innovationcentralph/LakeQualityMonitoring/KiCad Files/DOST_MainUnit/DOST_MainUnit.kicad_pcb

## KiCad design KiCad Files/DOST_MainUnit/DOST_MainUnit.kicad_pcb (2025-04-25)

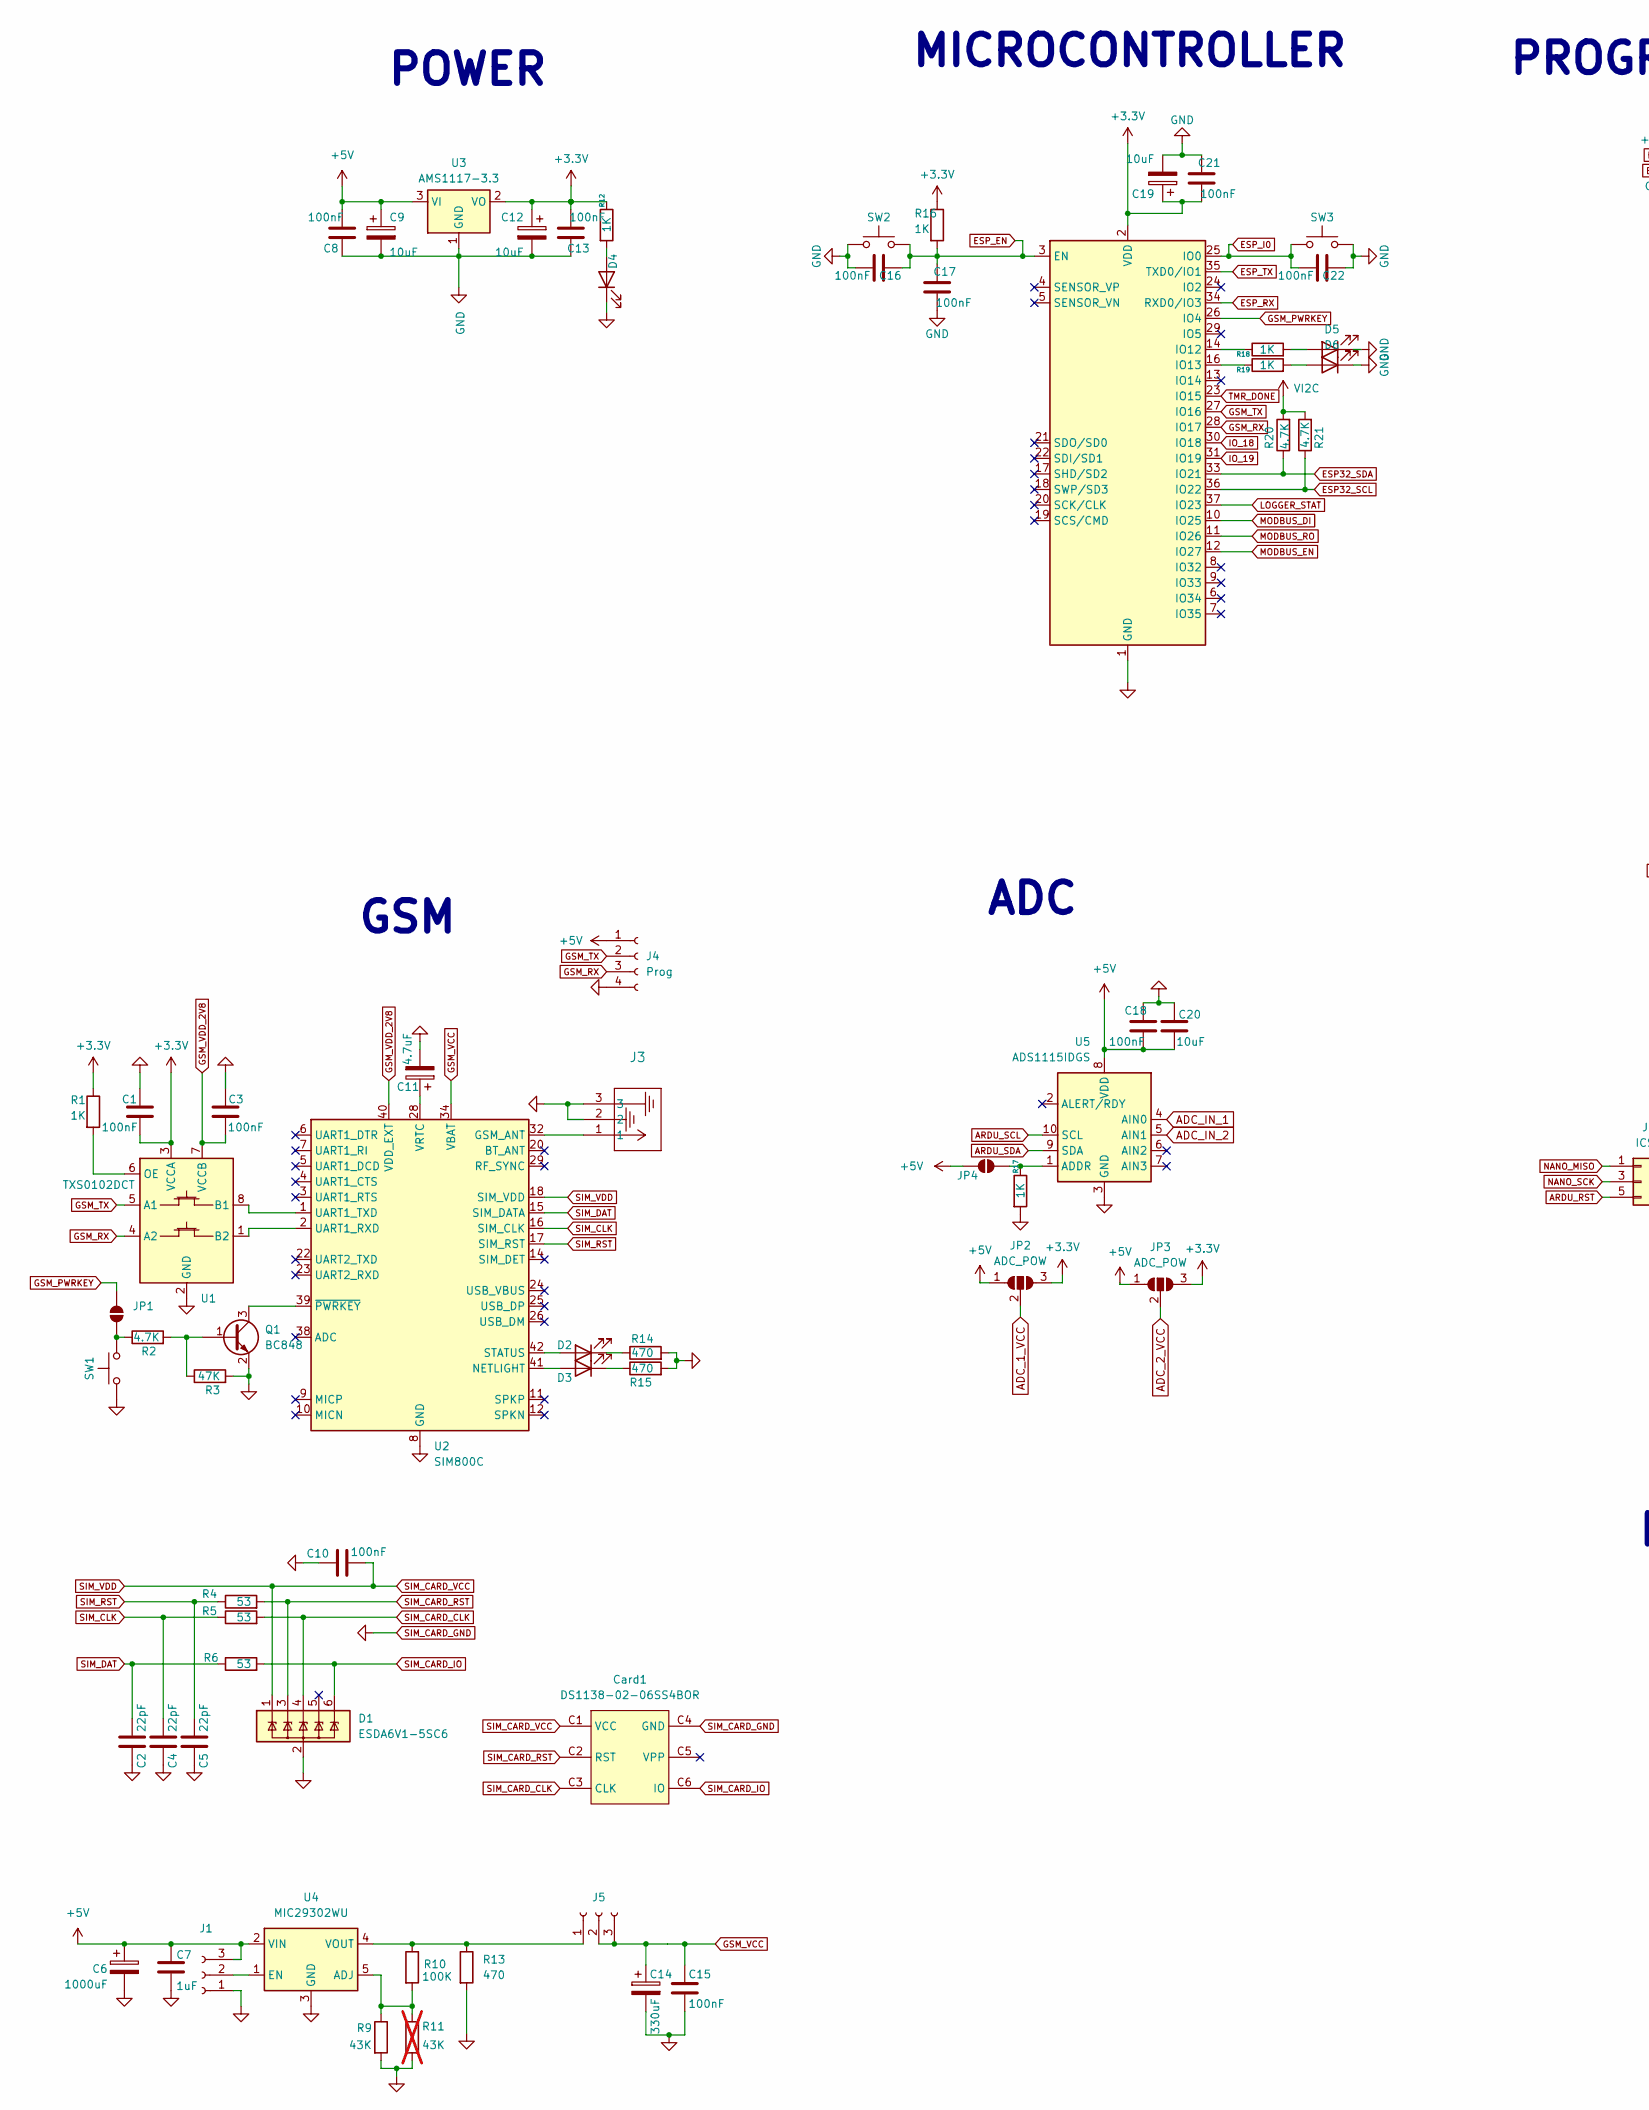
[picture p1: schematic DOST_MainUnit.kicad_sch, part in row 1, column 1]

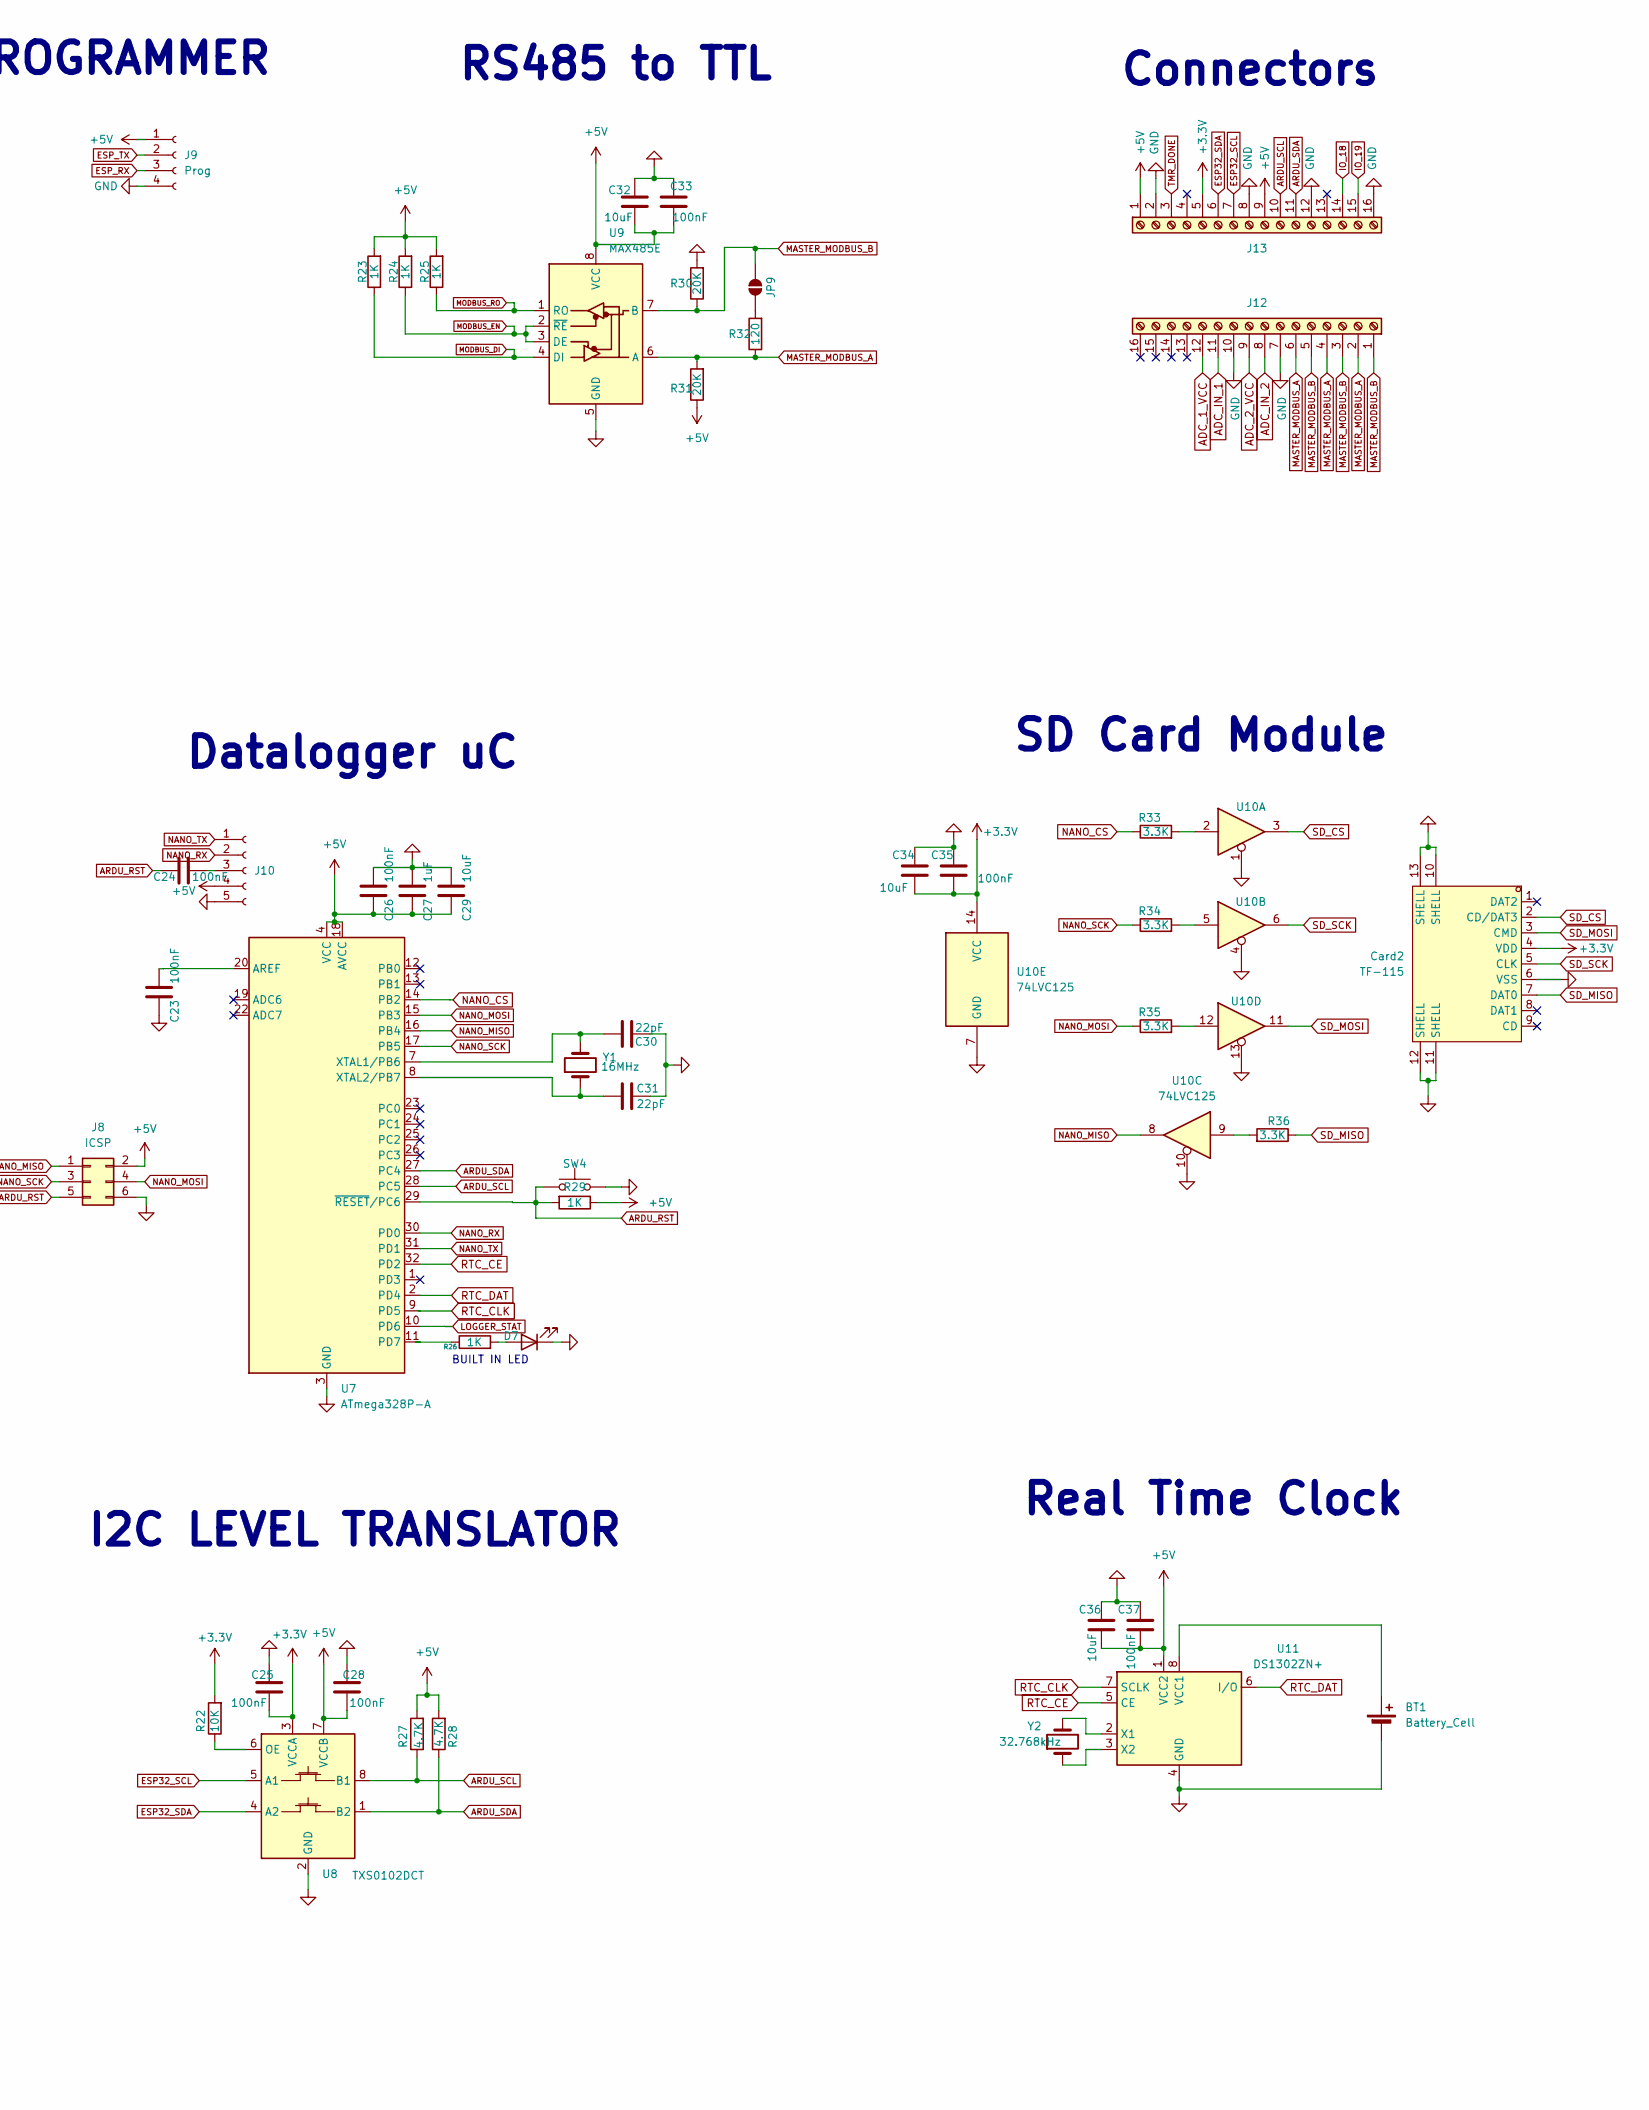
[picture p2: schematic DOST_MainUnit.kicad_sch, part in row 1, column 2]

Parts:
BT1: Battery_Cell; BAT-TH_CR2032-BS-6-1; LCSC C70377
C1, C3, C25, C28: 100nF; C_0805_2012Metric_Pad1.18x1.45mm_HandSolder; LCSC C1546
C2, C4, C5: 22pF; C_0805_2012Metric_Pad1.18x1.45mm_HandSolder
C6: 1000uF; CP_Elec_10x10.5
C7: 1uF; C_0805_2012Metric_Pad1.18x1.45mm_HandSolder
C8, C13, C16, C17, C18, C21, C22, C23, C24, C26, C33, C35, C37: 100nF; C_0805_2012Metric_Pad1.18x1.45mm_HandSolder; LCSC C60474
C9, C12, C19, C32: 10uF; C_0805_2012Metric_Pad1.18x1.45mm_HandSolder; LCSC C15850
C10, C15: 100nF; C_0805_2012Metric_Pad1.18x1.45mm_HandSolder
C11: 4.7uF; CP_EIA-3528-12_Kemet-T_Pad1.50x2.35mm_HandSolder
C14: 330uF; CP_EIA-7343-31_Kemet-D_Pad2.25x2.55mm_HandSolder
C20, C29, C34, C36: 10uF; C_0805_2012Metric_Pad1.18x1.45mm_HandSolder; LCSC C96446
C27: 1uF; C_0805_2012Metric_Pad1.18x1.45mm_HandSolder; LCSC C52923
C30, C31: 22pF; C_0805_2012Metric_Pad1.18x1.45mm_HandSolder; LCSC C96446
Card1: DS1138-02-06SS4BOR; SIM-SMD_DS1138-02-06SS4BOR; LCSC Part C91413
Card2: TF-115; TF-SMD_TF-115; LCSC C266620
D1: ESDA6V1-5SC6; SOT-23-6
D2, D3: LED; LED_0805_2012Metric_Pad1.15x1.40mm_HandSolder
D4, D5, D6, D7: LED; LED_0805_2012Metric_Pad1.15x1.40mm_HandSolder; LCSC C2297
J1, J5: Conn_01x03_Socket; PinHeader_1x03_P2.54mm_Vertical
J3: CONUFL001-SMD-T; CONN1_CONUFL_TEC
J4, J9: Prog; PinHeader_1x04_P2.54mm_Vertical
J8: ICSP; PinHeader_2x03_P2.54mm_Vertical_SMD
J10: Conn_01x05_Socket; PinHeader_1x05_P2.54mm_Vertical
J12, J13: Screw_Terminal_01x16; TerminalBlock_Phoenix_MKDS-1,5-16-5.08_1x16_P5.08mm_Horizon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
JP1, JP4, JP9: SolderJumper_2_Open; SolderJumper-2_P1.3mm_Open_Pad1.0x1.5mm
JP2, JP3: ADC_POW; SolderJumper-3_P1.3mm_Open_Pad1.0x1.5mm
Q1: BC848; SOT-23
R1, R12, R16, R17, R18, R19, R23, R24, R25, R26, R29: 1K; R_0603_1608Metric_Pad0.98x0.95mm_HandSolder; LCSC C21190
R2: 4.7K; R_0603_1608Metric_Pad0.98x0.95mm_HandSolder
R3: 47K; R_0805_2012Metric_Pad1.20x1.40mm_HandSolder
R4, R5, R6: 53; R_0805_2012Metric_Pad1.20x1.40mm_HandSolder
R9: 43K; R_0805_2012Metric_Pad1.20x1.40mm_HandSolder
R10: 100K; R_0805_2012Metric_Pad1.20x1.40mm_HandSolder
R11: 43K; R_0805_2012Metric_Pad1.20x1.40mm_HandSolder; not fitted
R13, R14, R15: 470; R_0805_2012Metric_Pad1.20x1.40mm_HandSolder
R20, R21, R27, R28: 4.7K; R_0603_1608Metric_Pad0.98x0.95mm_HandSolder; LCSC C23162
R22: 10K; R_0603_1608Metric_Pad0.98x0.95mm_HandSolder; LCSC C25804
R30, R31: 20K; R_0805_2012Metric_Pad1.20x1.40mm_HandSolder; LCSC C163978
R32: 120; R_0805_2012Metric_Pad1.20x1.40mm_HandSolder; LCSC C2907224
R33, R34, R35, R36: 3.3K; R_0603_1608Metric_Pad0.98x0.95mm_HandSolder; LCSC C22978
SW1, SW2, SW3, SW4: SW_Push; SW_SPST_CK_RS282G05A3; LCSC C2689642
U1, U8: TXS0102DCT; SSOP-8_2.95x2.8mm_P0.65mm
U2: SIM800C; SIMCom_SIM800C
U3: AMS1117-3.3; SOT-223-3_TabPin2
U4: MIC29302WU; TO-263-5_TabPin3
U5: ADS1115IDGS; VSSOP-10_3x3mm_P0.5mm; LCSC C37593
U6: ESP32-WROOM-32; LCSC C529577
U7: ATmega328P-A; TQFP-32_7x7mm_P0.8mm; LCSC C14877
U9: MAX485E; SOP-8_3.9x4.9mm_P1.27mm; LCSC C481667
U10: 74LVC125; TSSOP-14_L5.0-W4.4-P0.65-LS6.4-BL; LCSC C6059
U11: DS1302ZN+; SOIC-8_3.9x4.9mm_P1.27mm; LCSC C14334
Y1: 16MHz; Crystal_HC49-4H_Vertical
Y2: 32.768kHz; Crystal_C38-LF_D3.0mm_L8.0mm_Vertical; LCSC C97606

Connections:
+3.3V: C1.2, C12.1, C13.1, C19.1, C21.1, C25.2, C34.1, C35.1, Card2.4 (VDD), J13.5, JP2.3 (B), JP3.3 (B), R1.1, R12.1, R16.1, R22.2, U1.3 (VCCA), U3.2 (VO), U6.2 (VDD), U8.3 (VCCA), U10.14 (VCC)
+5V: C6.1, C7.1, C8.1, C9.1, C18.1, C20.2, C26.2, C27.2, C28.2, C29.2, C32.2, C33.1, C36.1, C37.1, J1.3, J4.1, J8.2, J9.1, J10.4, J13.1, J13.9, JP2.1 (A), JP3.1 (A), JP4.2 (B), R23.2, R24.2, R25.2, R27.2, R28.2, R29.1, R31.1, U3.3 (VI), U4.2 (VIN), U5.8 (VDD), U7.4 (VCC), U7.6 (VCC), U7.18 (AVCC), U8.7 (VCCB), U9.8 (VCC), U11.1 (VCC2)
ADC_1_VCC: J12.12, JP2.2 (C)
ADC_2_VCC: J12.9, JP3.2 (C)
ADC_IN_1: J12.11, U5.4 (AIN0)
ADC_IN_2: J12.8, U5.5 (AIN1)
ARDU_RST: C24.2, J8.5, R29.2, SW4.1, U7.29 (~RESET/PC6)
ARDU_SCL: J13.10, R27.1, U5.10 (SCL), U7.28 (PC5), U8.8 (B1)
ARDU_SDA: J13.11, R28.1, U5.9 (SDA), U7.27 (PC4), U8.1 (B2)
ESP32_SCL: J13.7, R21.1, U6.36 (IO22), U8.5 (A1)
ESP32_SDA: J13.6, R20.1, U6.33 (IO21), U8.4 (A2)
ESP_EN: C16.2, C17.2, R16.2, SW2.2, U6.3 (EN)
ESP_I0: C22.1, SW3.1, U6.25 (IO0)
ESP_RX: J9.3, U6.34 (RXD0/IO3)
ESP_TX: J9.2, U6.35 (TXD0/IO1)
GSM_PWRKEY: JP1.2 (B), U6.26 (IO4)
GSM_RX: J4.3, U1.4 (A2), U6.28 (IO17)
GSM_TX: J4.2, U1.5 (A1), U6.27 (IO16)
GSM_VCC: C14.1, C15.1, J5.2, J5.3, U2.34 (VBAT), U2.35 (VBAT)
GSM_VDD_2V8: C3.2, U1.7 (VCCB), U2.40 (VDD_EXT)
IO_18: J13.14, U6.30 (IO18)
IO_19: J13.15, U6.31 (IO19)
LOGGER_STAT: U6.37 (IO23), U7.10 (PD6)
MASTER_MODBUS_A: J12.2, J12.4, J12.6, R31.2, R32.1, U9.6 (A)
MASTER_MODBUS_B: J12.1, J12.3, J12.5, JP9.2 (B), R30.1, U9.7 (B)
MODBUS_DI: R23.1, U6.10 (IO25), U9.4 (DI)
MODBUS_EN: R24.1, U6.12 (IO27), U9.2 (~RE), U9.3 (DE)
MODBUS_RO: R25.1, U6.11 (IO26), U9.1 (RO)
NANO_CS: R33.1, U7.14 (PB2)
NANO_MISO: J8.1, U7.16 (PB4), U10.8
NANO_MOSI: J8.4, R35.1, U7.15 (PB3)
NANO_RX: J10.2, U7.30 (PD0)
NANO_SCK: J8.3, R34.1, U7.17 (PB5)
NANO_TX: J10.1, U7.31 (PD1)
unnamed: BT1.1 (+), U11.8 (VCC1)
unnamed: D2.2 (A), U2.42 (STATUS)
unnamed: D2.1 (K), R14.1
unnamed: D3.2 (A), U2.41 (NETLIGHT)
unnamed: D3.1 (K), R15.1
unnamed: D4.2 (A), R12.2
unnamed: D5.2 (A), R18.2
unnamed: D6.2 (A), R19.2
unnamed: D7.2 (A), R26.2
unnamed: J1.2, U4.1 (EN)
unnamed: J5.1, R10.1, R13.1, U4.4 (VOUT)
unnamed: C24.1, J10.3
unnamed: JP1.1 (A), R2.1, SW1.2
unnamed: JP4.1 (A), R17.1, U5.1 (ADDR)
unnamed: JP9.1 (A), R32.2
unnamed: Q1.1 (B), R2.2, R3.1
unnamed: Q1.3 (C), U2.39 (~PWRKEY)
unnamed: R33.2, U10.2
unnamed: R34.2, U10.5
unnamed: R35.2, U10.12
unnamed: R36.2, U10.9
unnamed: U1.8 (B1), U2.1 (UART1_TXD)
unnamed: U1.1 (B2), U2.2 (UART1_RXD)
unnamed: R1.2, U1.6 (OE)
unnamed: J3.1, U2.32 (GSM_ANT)
unnamed: C11.1, U2.28 (VRTC)
unnamed: R9.1, R10.2, R11.1, U4.5 (ADJ)
unnamed: R18.1, U6.14 (IO12)
unnamed: R19.1, U6.16 (IO13)
unnamed: C23.1, U7.20 (AREF)
unnamed: R26.1, U7.11 (PD7)
unnamed: C30.1, U7.7 (XTAL1/PB6), Y1.2
unnamed: C31.1, U7.8 (XTAL2/PB7), Y1.1
unnamed: R22.1, U8.6 (OE)
unnamed: U11.2 (X1), Y2.2
unnamed: U11.3 (X2), Y2.1
RTC_CE: U7.32 (PD2), U11.5 (CE)
RTC_CLK: U7.9 (PD5), U11.7 (SCLK)
RTC_DAT: U7.2 (PD4), U11.6 (I/O)
SD_CS: Card2.2 (CD/DAT3), U10.3
SD_MISO: Card2.7 (DAT0), R36.1
SD_MOSI: Card2.3 (CMD), U10.11
SD_SCK: Card2.5 (CLK), U10.6
SIM_CARD_CLK: Card1.C3 (CLK), D1.4 (IO3), R5.2
SIM_CARD_GND: BT1.2 (-), C1.1, C2.1, C3.1, C4.1, C5.1, C6.2, C7.2, C8.2, C9.2, C10.1, C11.2, C12.2, C13.2, C14.2, C15.2, C16.1, C17.1, C18.2, C19.2, C20.1, C21.2, C22.2, C23.2, C25.1, C26.1, C27.1, C28.1, C29.1, C30.2, C31.2, C32.1, C33.2, C34.2, C35.2, C36.2, C37.2, Card1.C4 (GND), Card2.6 (VSS), Card2.10 (SHELL), Card2.11 (SHELL), Card2.12 (SHELL), Card2.13 (SHELL), D1.2 (GND), D4.1 (K), D5.1 (K), D6.1 (K), D7.1 (K), J1.1, J3.2, J3.3, J4.4, J8.6, J9.4, J10.5, J12.7, J12.10, J13.2, J13.8, J13.12, J13.16, Q1.2 (E), R3.2, R9.2, R11.2, R13.2, R14.2, R15.2, R17.2, R30.2, SW1.1, SW2.1, SW3.2, SW4.2, U1.2 (GND), U2.8 (GND), U2.13 (GND), U2.19 (GND), U2.21 (GND), U2.27 (GND), U2.30 (GND), U2.31 (GND), U2.33 (GND), U2.36 (GND), U2.37 (GND), U3.1 (GND), U4.3 (GND), U5.3 (GND), U6.1 (GND), U6.15 (GND), U6.38 (GND), U6.39 (GND), U7.3 (GND), U7.5 (GND), U7.21 (GND), U8.2 (GND), U9.5 (GND), U10.1, U10.4, U10.7 (GND), U10.10, U10.13, U11.4 (GND)
SIM_CARD_IO: Card1.C6 (IO), D1.6 (IO5), R6.2
SIM_CARD_RST: Card1.C2 (RST), D1.3 (IO2), R4.2
SIM_CARD_VCC: C10.2, Card1.C1 (VCC), D1.1 (IO1), U2.18 (SIM_VDD)
SIM_CLK: C4.2, R5.1, U2.16 (SIM_CLK)
SIM_DAT: C2.2, R6.1, U2.15 (SIM_DATA)
SIM_RST: C5.2, R4.1, U2.17 (SIM_RST)
TMR_DONE: J13.3, U6.23 (IO15)
VI2C: R20.2, R21.2

Notes on the sheet:
Datalogger uC
RS485 to TTL
SD Card Module
GSM
I2C LEVEL TRANSLATOR
Connectors
POWER
MICROCONTROLLER
Real Time Clock
BUILT IN LED
PROGRAMMER
ADC

Board: 2 copper layers, 113 parts (1 on the bottom side), 87 nets, no tracks yet.
