innovationcentralph/LakeQualityMonitoring/KiCad Files/DOST_LoRa/DOST_LoRa.kicad_pcb

## KiCad design KiCad Files/DOST_LoRa/DOST_LoRa.kicad_pcb (2025-04-25)

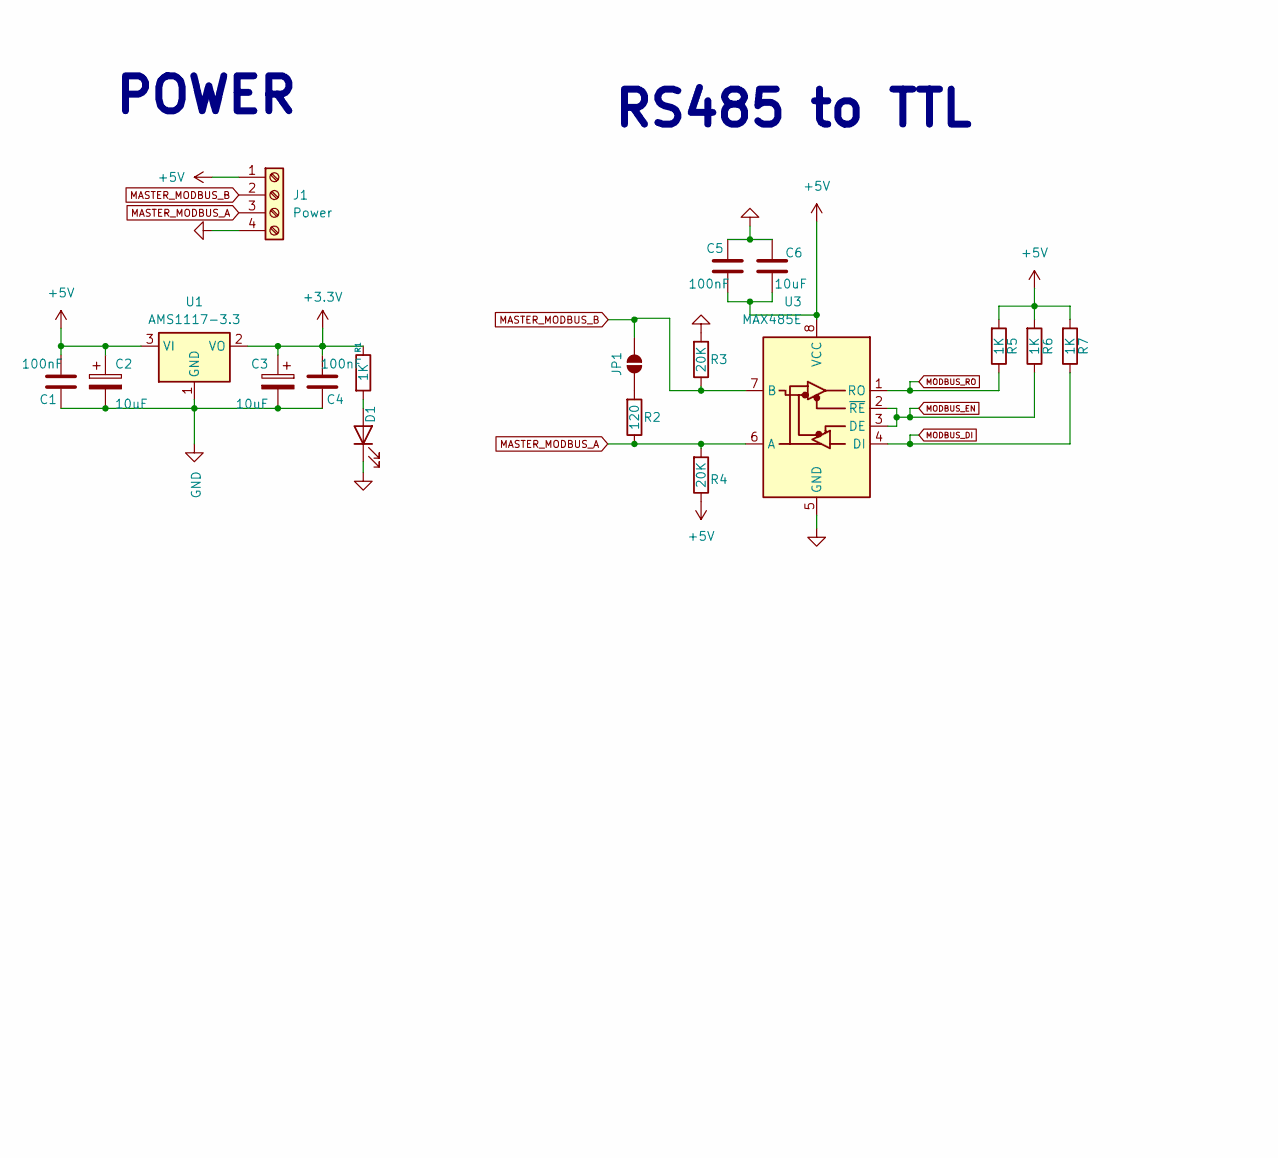
[picture p3: schematic DOST_LoRa.kicad_sch, part in row 1, column 1]

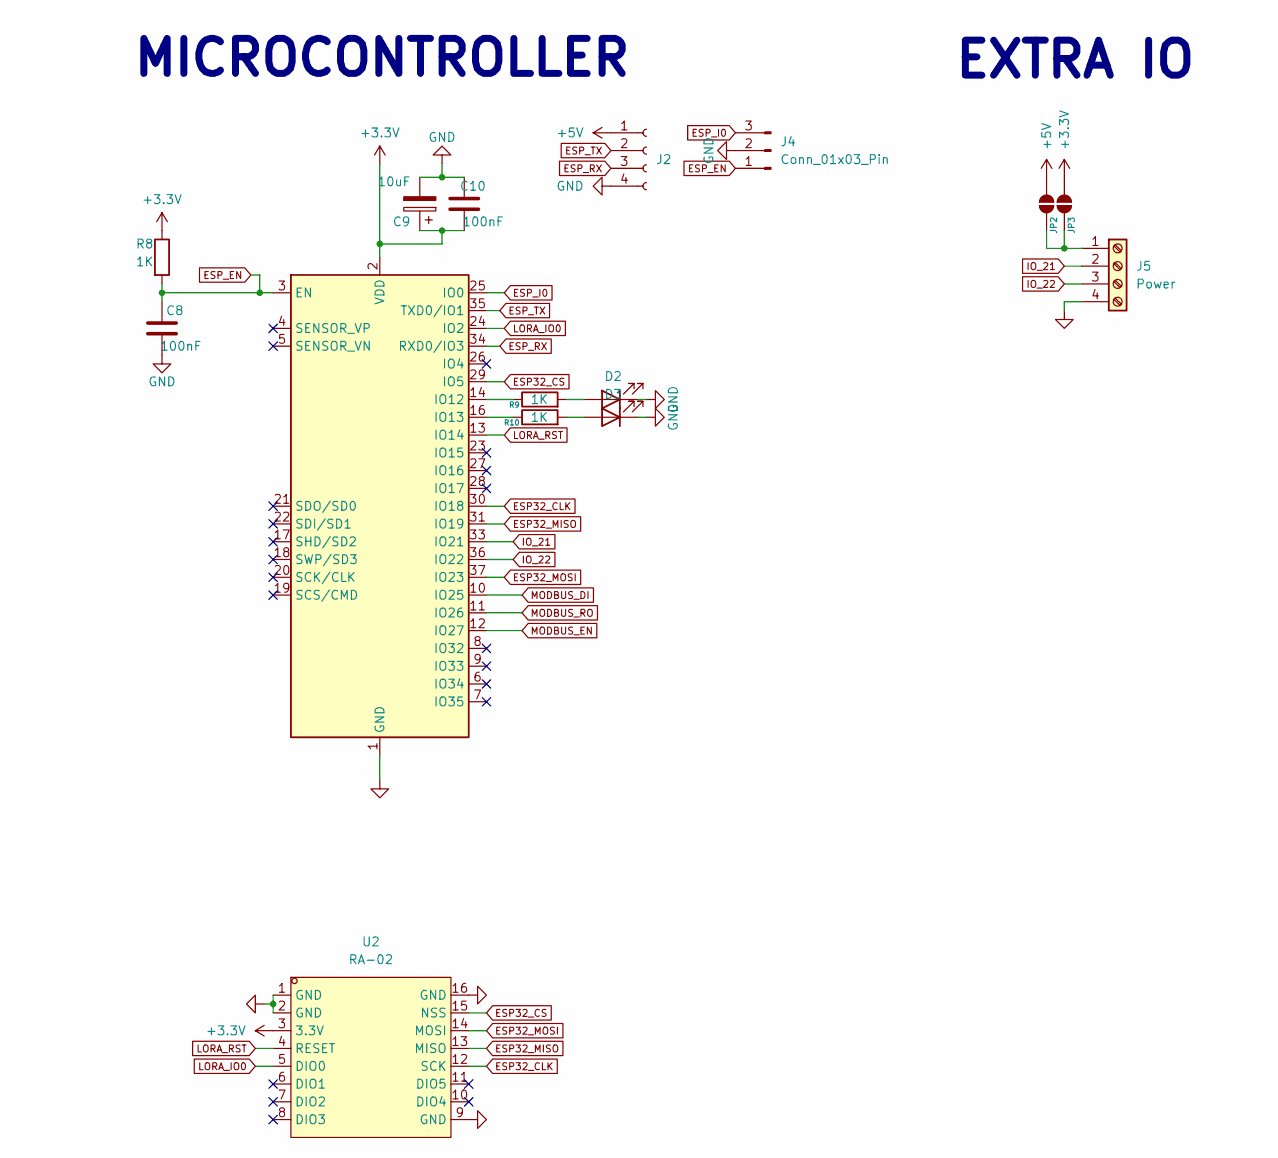
[picture p4: schematic DOST_LoRa.kicad_sch, part in row 1, column 2]

Parts:
C1, C4, C5, C8, C10: 100nF; C_0805_2012Metric_Pad1.18x1.45mm_HandSolder; LCSC C60474
C2, C3, C6, C9: 10uF; C_0805_2012Metric_Pad1.18x1.45mm_HandSolder; LCSC C15850
D1, D2, D3: LED; LED_0805_2012Metric_Pad1.15x1.40mm_HandSolder; LCSC C2297
J1, J5: Power; TerminalBlock_Phoenix_MKDS-1,5-4-5.08_1x04_P5.08mm_Horizont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
J2: PinHeader_1x04_P2.54mm_Vertical
J4: Conn_01x03_Pin; PinHeader_1x03_P2.54mm_Vertical
JP1, JP2, JP3: SolderJumper_2_Open; SolderJumper-2_P1.3mm_Open_Pad1.0x1.5mm
R1, R5, R6, R7, R8, R9, R10: 1K; R_0603_1608Metric_Pad0.98x0.95mm_HandSolder; LCSC C21190
R2: 120; R_0805_2012Metric_Pad1.20x1.40mm_HandSolder; LCSC C2907224
R3, R4: 20K; R_0805_2012Metric_Pad1.20x1.40mm_HandSolder; LCSC C163978
U1: AMS1117-3.3; SOT-223-3_TabPin2
U2: RA-02; WIRELM-SMD_RA-02-BL; LCSC Part C90039
U3: MAX485E; SOP-8_3.9x4.9mm_P1.27mm; LCSC C481667
U4: ESP32-WROOM-32; ESP32-WROOM-32U; LCSC C529577

Connections:
+3.3V: C3.1, C4.1, C9.1, C10.1, JP3.2 (B), R1.1, R8.1, U1.2 (VO), U2.3 (3.3V), U4.2 (VDD)
+5V: C1.1, C2.1, C5.1, C6.2, J1.1, J2.1, JP2.2 (B), R4.1, R5.2, R6.2, R7.2, U1.3 (VI), U3.8 (VCC)
ESP32_CLK: U2.12 (SCK), U4.30 (IO18)
ESP32_CS: U2.15 (NSS), U4.29 (IO5)
ESP32_MISO: U2.13 (MISO), U4.31 (IO19)
ESP32_MOSI: U2.14 (MOSI), U4.37 (IO23)
ESP_EN: C8.2, J4.1, R8.2, U4.3 (EN)
ESP_I0: J4.3, U4.25 (IO0)
ESP_RX: J2.3, U4.34 (RXD0/IO3)
ESP_TX: J2.2, U4.35 (TXD0/IO1)
GND: C1.2, C2.2, C3.2, C4.2, C5.2, C6.1, C8.1, C9.2, C10.2, D1.1 (K), D2.1 (K), D3.1 (K), J1.4, J2.4, J4.2, J5.4, R3.2, U1.1 (GND), U2.1 (GND), U2.2 (GND), U2.9 (GND), U2.16 (GND), U3.5 (GND), U4.1 (GND), U4.15 (GND), U4.38 (GND), U4.39 (GND)
IO_21: J5.2, U4.33 (IO21)
IO_22: J5.3, U4.36 (IO22)
LORA_IO0: U2.5 (DIO0), U4.24 (IO2)
LORA_RST: U2.4 (RESET), U4.13 (IO14)
MASTER_MODBUS_A: J1.3, R2.1, R4.2, U3.6 (A)
MASTER_MODBUS_B: J1.2, JP1.2 (B), R3.1, U3.7 (B)
MODBUS_DI: R7.1, U3.4 (DI), U4.10 (IO25)
MODBUS_EN: R6.1, U3.2 (~RE), U3.3 (DE), U4.12 (IO27)
MODBUS_RO: R5.1, U3.1 (RO), U4.11 (IO26)
unnamed: D1.2 (A), R1.2
unnamed: D2.2 (A), R9.2
unnamed: D3.2 (A), R10.2
unnamed: J5.1, JP2.1 (A), JP3.1 (A)
unnamed: JP1.1 (A), R2.2
unnamed: R9.1, U4.14 (IO12)
unnamed: R10.1, U4.16 (IO13)

Notes on the sheet:
EXTRA IO
POWER
MICROCONTROLLER
RS485 to TTL

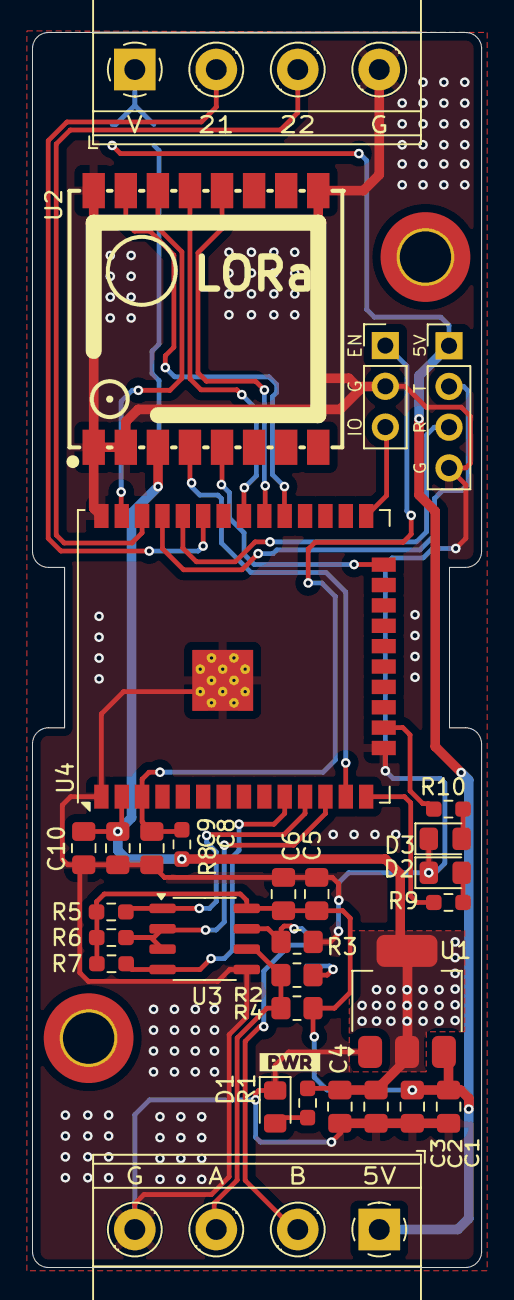
[picture p5: board DOST_LoRa.kicad_pcb from above]

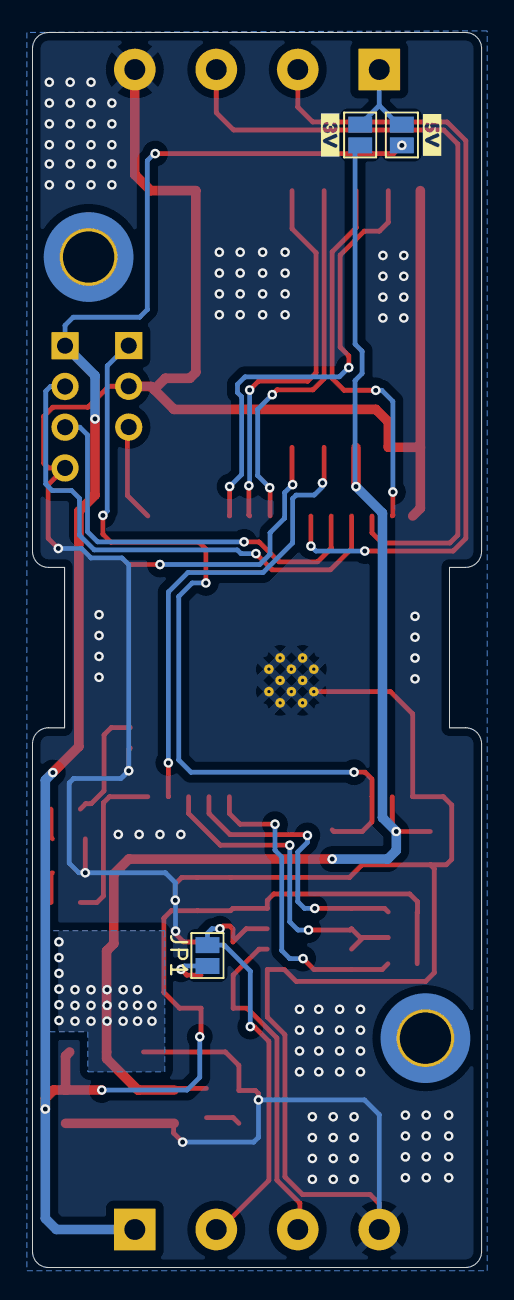
[picture p6: board DOST_LoRa.kicad_pcb from below]

Board: 2 copper layers, 28.0 x 77.0 mm, 36 parts (5 on the bottom side), 27 nets.

Other parts of the board:
kibuzzard-6783FC2A: G***; kibuzzard-6783FC2A
kibuzzard-6783FC31: G***; kibuzzard-6783FC31
kibuzzard-6783FECC: G***; kibuzzard-6783FECC
