innovationcentralph/LakeQualityMonitoring/KiCad Files/DOST_PowerGate/DOST_PowerGate.kicad_pcb

## KiCad design KiCad Files/DOST_PowerGate/DOST_PowerGate.kicad_pcb (2025-04-25)

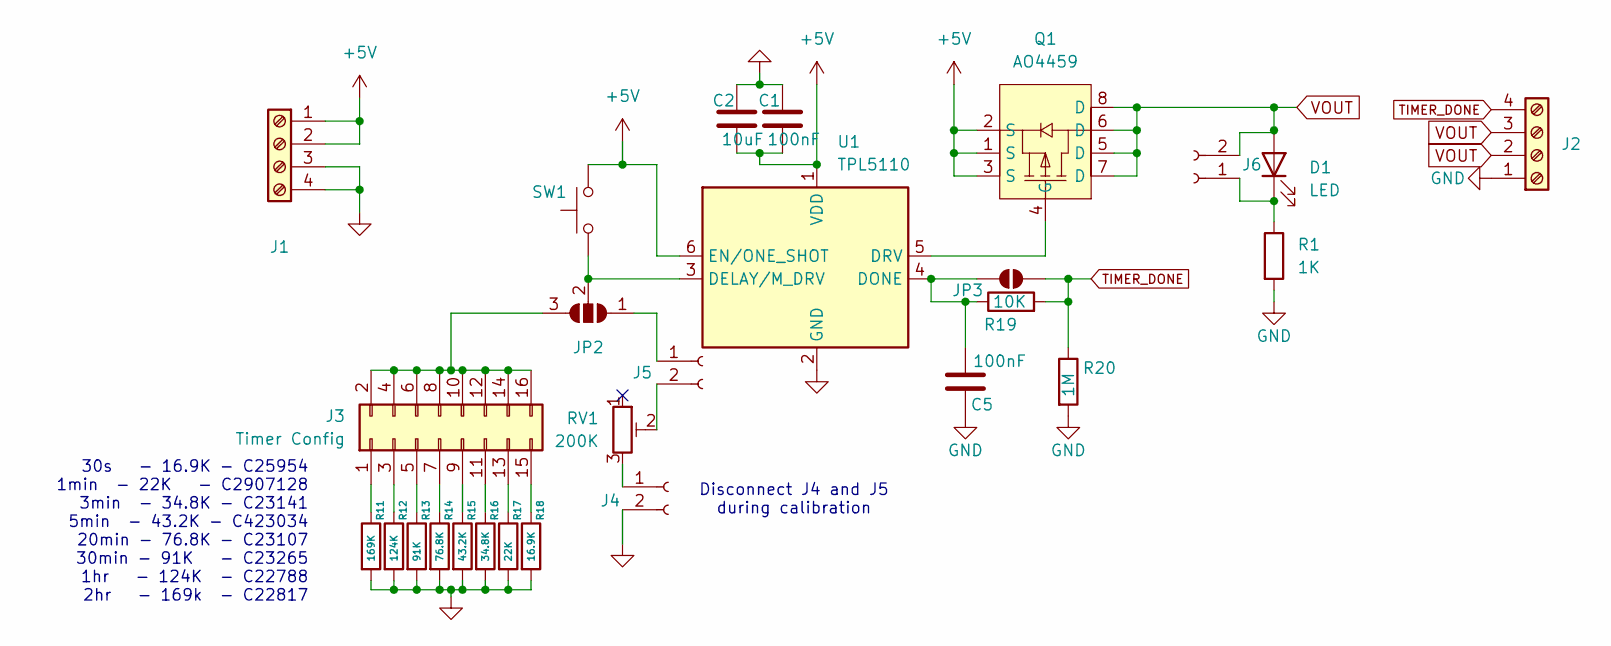
[picture p7: schematic DOST_PowerGate.kicad_sch]

Parts:
C1: 100nF; C_0805_2012Metric_Pad1.18x1.45mm_HandSolder
C2: 10uF; C_0805_2012Metric_Pad1.18x1.45mm_HandSolder
C5: 100nF; C_0805_2012Metric_Pad1.18x1.45mm_HandSolder; LCSC C60474
D1: LED; LED_0805_2012Metric_Pad1.15x1.40mm_HandSolder
J1, J2: Screw_Terminal_01x04; TerminalBlock_Phoenix_MKDS-1,5-4-5.08_1x04_P5.08mm_Horizont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
J3: Timer Config; PinHeader_2x08_P2.54mm_Vertical
J4, J5, J6: Conn_01x02_Socket; PinHeader_1x02_P2.54mm_Vertical
JP2: SolderJumper_3_Open; SolderJumper-3_P1.3mm_Open_Pad1.0x1.5mm
JP3: SolderJumper_2_Open; SolderJumper-2_P1.3mm_Open_Pad1.0x1.5mm
Q1: AO4459; SOP-8_L5.0-W4.0-P1.27-LS6.2-BL; LCSC Part C49047
R1: 1K; R_0603_1608Metric_Pad0.98x0.95mm_HandSolder
R11: 169K; R_0805_2012Metric_Pad1.20x1.40mm_HandSolder; LCSC C22817
R12: 124K; R_0805_2012Metric_Pad1.20x1.40mm_HandSolder; LCSC C22788
R13: 91K; R_0805_2012Metric_Pad1.20x1.40mm_HandSolder; LCSC C23265
R14: 76.8K; R_0805_2012Metric_Pad1.20x1.40mm_HandSolder; LCSC C23107
R15: 43.2K; R_0805_2012Metric_Pad1.20x1.40mm_HandSolder; LCSC C423034
R16: 34.8K; R_0805_2012Metric_Pad1.20x1.40mm_HandSolder; LCSC C23141
R17: 22K; R_0805_2012Metric_Pad1.20x1.40mm_HandSolder; LCSC C2907128
R18: 16.9K; R_0805_2012Metric_Pad1.20x1.40mm_HandSolder; LCSC C25954
R19: 10K; R_0603_1608Metric_Pad0.98x0.95mm_HandSolder; LCSC C105578
R20: 1M; R_0805_2012Metric_Pad1.20x1.40mm_HandSolder; LCSC C105578
RV1: 200K; Potentiometer_Bourns_3296W_Vertical
SW1: SW_Push; PinHeader_1x02_P2.54mm_Vertical
U1: TPL5110; SOT-23-6

Connections:
+5V: C1.2, C2.2, J1.1, J1.2, Q1.1 (S), Q1.2 (S), Q1.3 (S), SW1.2, U1.1 (VDD), U1.6 (EN/ONE_SHOT)
GND: C1.1, C2.1, C5.2, J1.3, J1.4, J2.1, J4.2, R1.2, R11.2, R12.2, R13.2, R14.2, R15.2, R16.2, R17.2, R18.2, R20.2, U1.2 (GND)
unnamed: D1.1 (K), J6.1, R1.1
unnamed: J3.1, R11.1
unnamed: J3.3, R12.1
unnamed: J3.5, R13.1
unnamed: J3.7, R14.1
unnamed: J3.9, R15.1
unnamed: J3.2, J3.4, J3.6, J3.8, J3.10, J3.12, J3.14, J3.16, JP2.3 (B)
unnamed: J3.11, R16.1
unnamed: J3.13, R17.1
unnamed: J3.15, R18.1
unnamed: J4.1, RV1.3
unnamed: J5.1, JP2.1 (A)
unnamed: J5.2, RV1.2
unnamed: JP2.2 (C), SW1.1, U1.3 (DELAY/M_DRV)
unnamed: C5.1, JP3.1 (A), R19.1, U1.4 (DONE)
unnamed: Q1.4 (G), U1.5 (DRV)
TIMER_DONE: J2.4, JP3.2 (B), R19.2, R20.1
VOUT: D1.2 (A), J2.2, J2.3, J6.2, Q1.5 (D), Q1.6 (D), Q1.7 (D), Q1.8 (D)

Notes on the sheet:
30s - 16.9K - C25954 1min - 22K - C2907128 3min - 34.8K - C23141 5min - 43.2K - C423034 20min - 76.8K - C23107 30min - 91K - C23265 1hr - 124K - C22788 2hr - 169k - C22817
Disconnect J4 and J5 during calibration

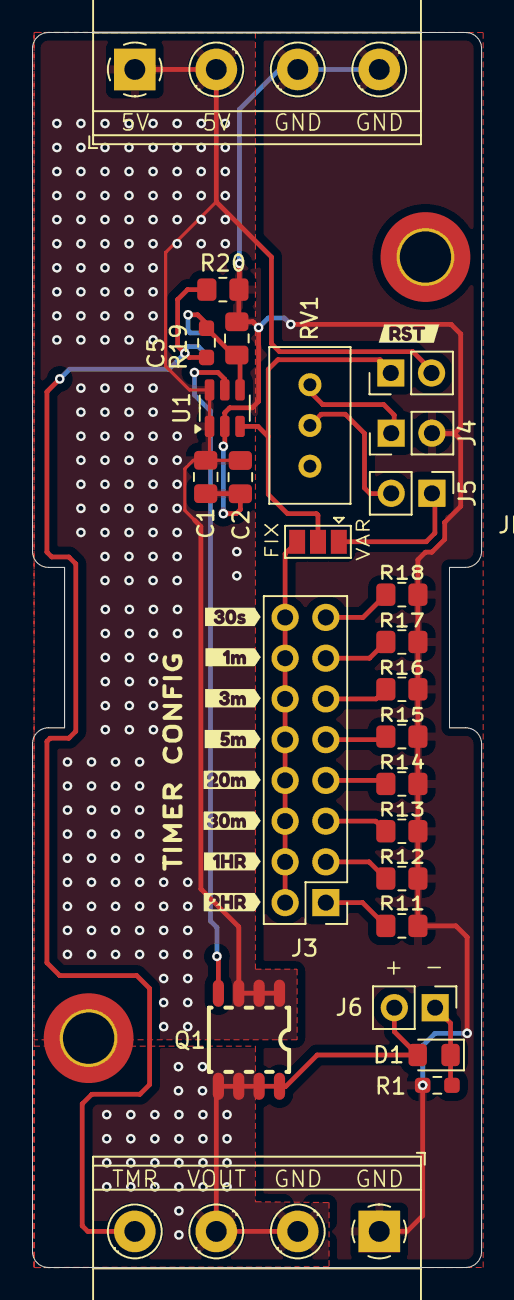
[picture p8: board DOST_PowerGate.kicad_pcb from above]

Board: 2 copper layers, 28.0 x 77.0 mm, 36 parts (1 on the bottom side), 20 nets.

Other parts of the board:
kibuzzard-678005E5: G***; kibuzzard-678005E5
kibuzzard-678005F6: G***; kibuzzard-678005F6
kibuzzard-6780055F: G***; kibuzzard-6780055F
kibuzzard-6780061E: G***; kibuzzard-6780061E
kibuzzard-6780065B: G***; kibuzzard-6780065B
kibuzzard-6780088B: G***; kibuzzard-6780088B
kibuzzard-67800525: G***; kibuzzard-67800525
kibuzzard-67800635: G***; kibuzzard-67800635
kibuzzard-67800642: G***; kibuzzard-67800642
