innovationcentralph/LakeQualityMonitoring/SourceCodes/DisplayUnit/LoraEndNode/PinConfig.h

#ifndef PIN_CONFIG_H
#define PIN_CONFIG_H

// RS485 Pin Definitions
#define TX_PIN 25              // TX GPIO pin for RS485
#define RX_PIN 26              // RX GPIO pin for RS485
#define TXRX_CONTROL_PIN 27    // TX/RX control pin for RS485 transceiver

#define MODBUS_LED  12

#endif // PIN_CONFIG_H
