innovationcentralph/LakeQualityMonitoring/(commit log)

2025-03-04 Initial Commit
    Added Working Firmware
    Sensor Reading
    Lora Sending
    LCD Display Update
    Gateway Code
2025-04-25 Fixed directory for firmware and added hardware files
    [DOST_DisplayUnit.kicad_pcb, DOST_DisplayUnit.kicad_sch, DOST_LoRa.kicad_pcb, DOST_LoRa.kicad_sch, DOST_MainUnit.kicad_pcb, DOST_MainUnit.kicad_sch, DOST_PowerGate.kicad_pcb, DOST_PowerGate.kicad_sch]
